yoshasudungan/qmk_firmware/keyboards/pheromone/keymaps/default/readme.md

# Default Keymap
---
The default keymap allows you contol 26 different sliders in lightroom.
## Base layer



## Function layer



## Lightroom layer
