yoshasudungan/qmk_firmware/mechanics/case/brand/brand.stl

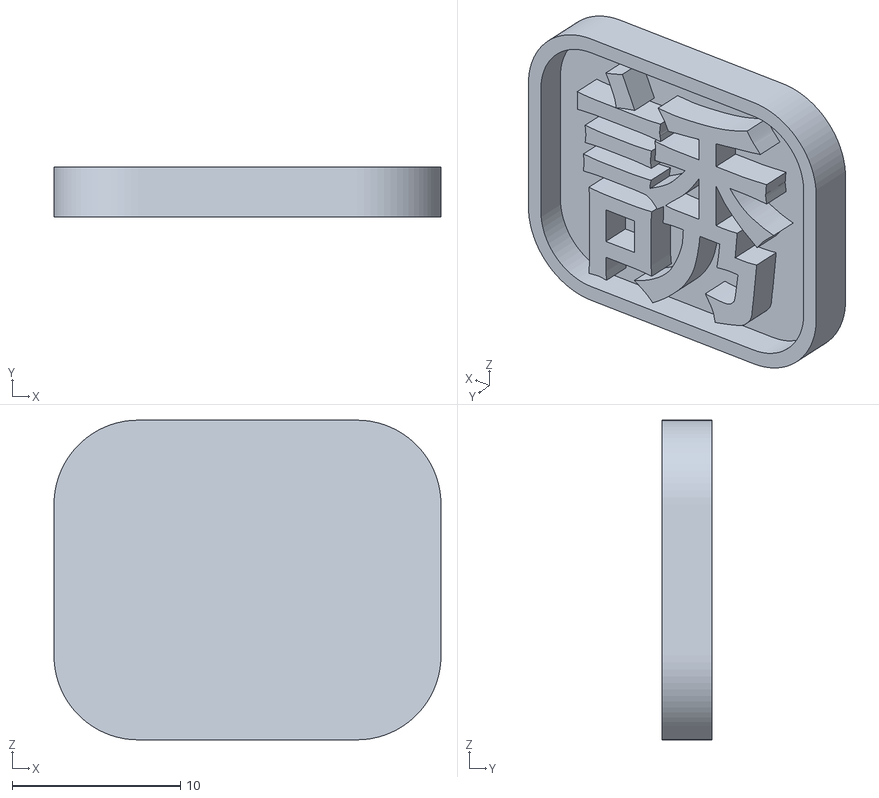
[picture p1: CAD file, 2020-08-31]
mechanics/case/brand/brand.stl
23.0 x 3.00 x 19.0
