yoshasudungan/qmk_firmware/mechanics/case/case.stl

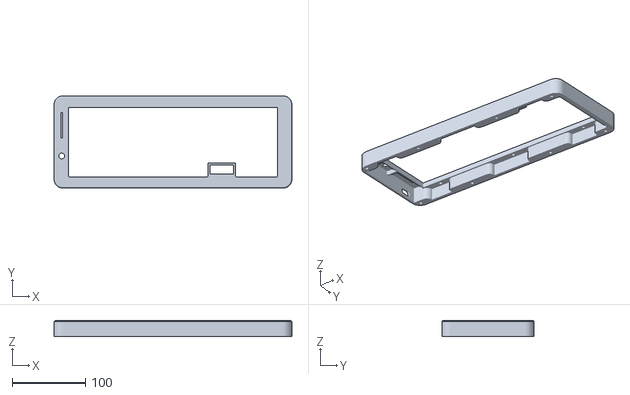
[picture p2: CAD file, 2020-08-31]
mechanics/case/case.stl
325.8 x 126.0 x 22.1
