yoshasudungan/qmk_firmware/mechanics/plate/Plate.step

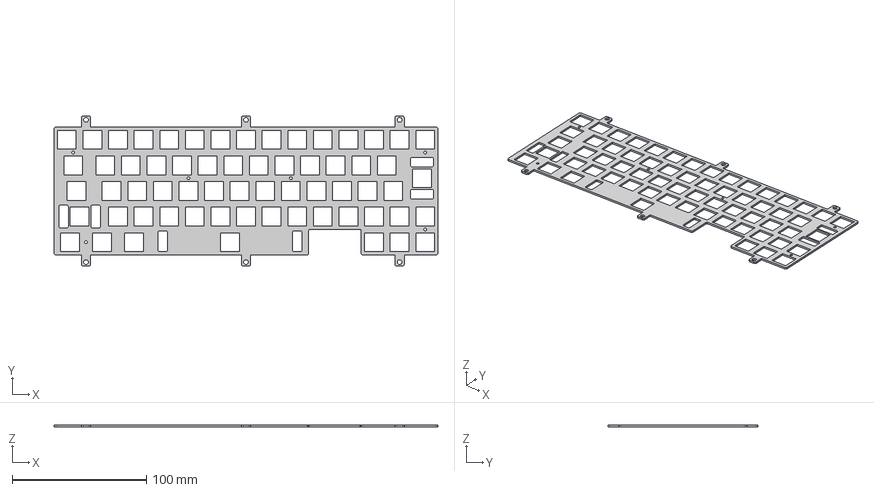
[picture p3: CAD file, 2020-08-31]
mechanics/plate/Plate.step
285.7 x 111.8 x 1.50 mm
