yoshasudungan/qmk_firmware/mechanics/slider cap/slide cap.stl

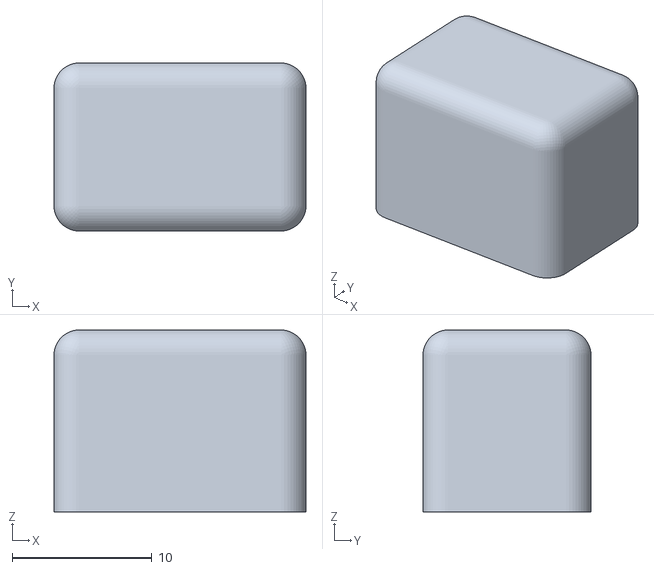
[picture p4: CAD file, 2020-08-31]
mechanics/slider cap/slide cap.stl
18.0 x 12.0 x 13.0
