yoshasudungan/qmk_firmware/mechanics/case/buttom_plate.dxf

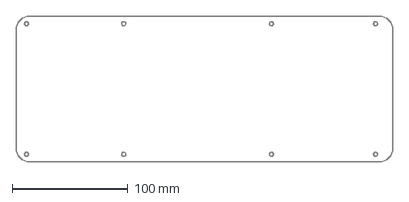
[picture p5: CAD file, 2020-08-31]
mechanics/case/buttom_plate.dxf
325.7 x 126.0 mm
