yoshasudungan/qmk_firmware/(list of files, cad)

Other CAD files:
mechanics/case/case_bigger_mounting_holes.stl
mechanics/case/case.f3z
mechanics/plate/plate.dxf
