yoshasudungan/qmk_firmware/pcb/pheromone.kicad_pcb

## KiCad design pcb/pheromone.kicad_pcb (2020-08-31)

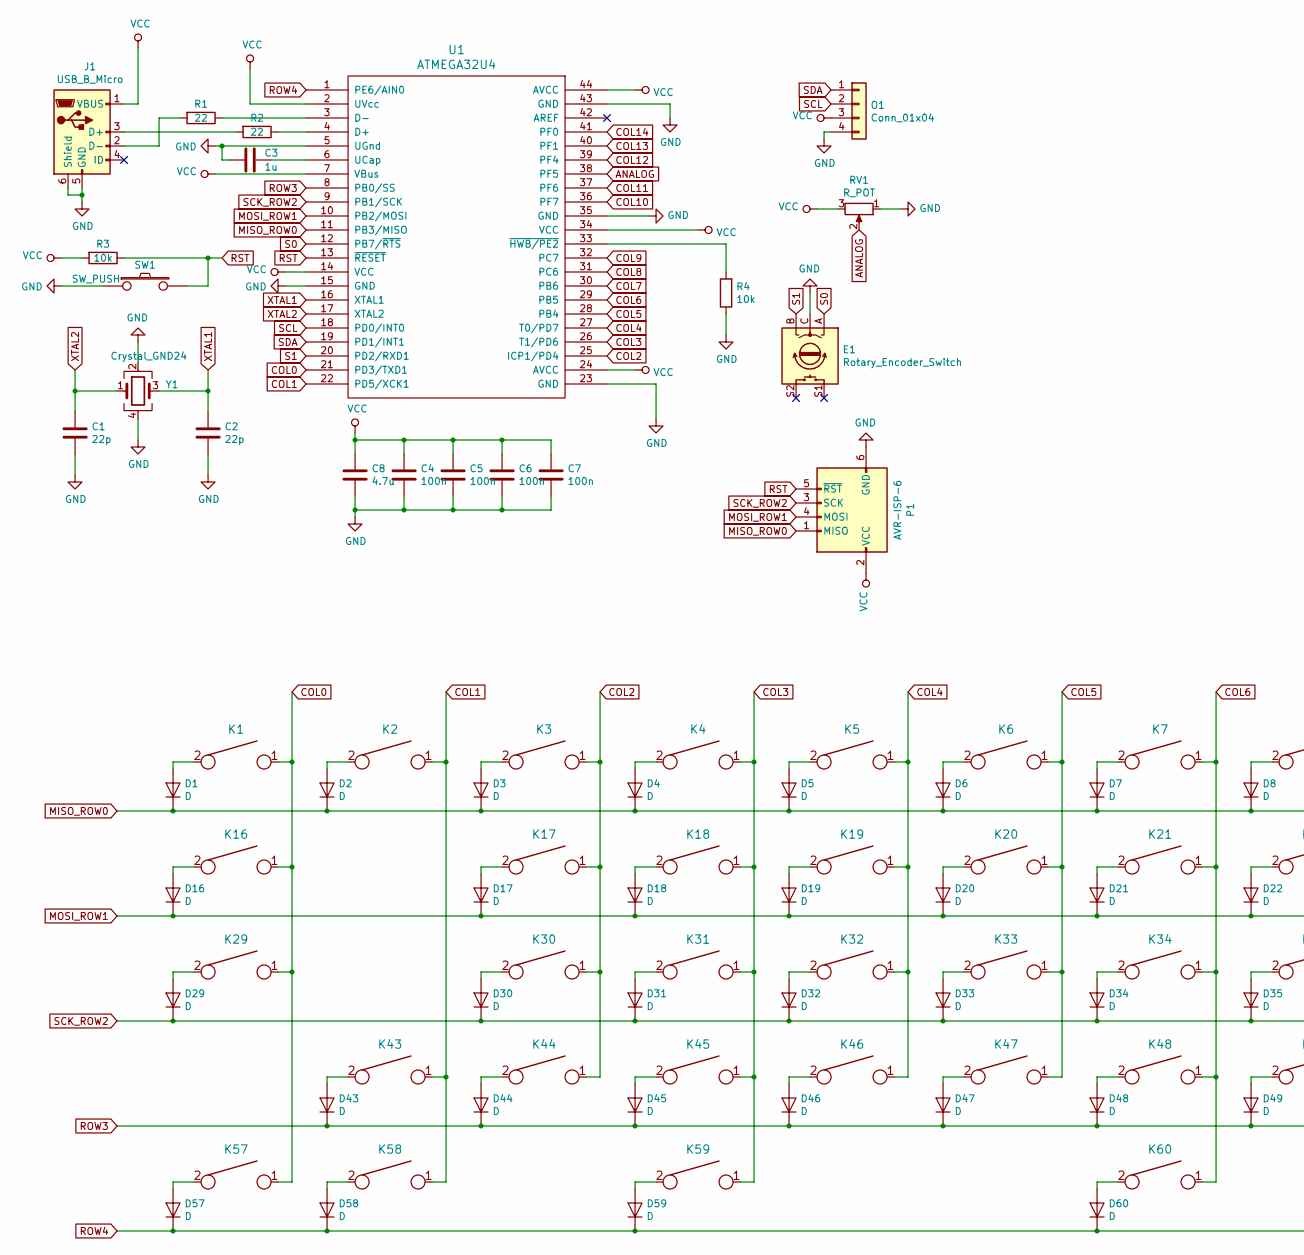
[picture p6: schematic pheromone.sch, Crusher keyboard, part in row 1, column 1]

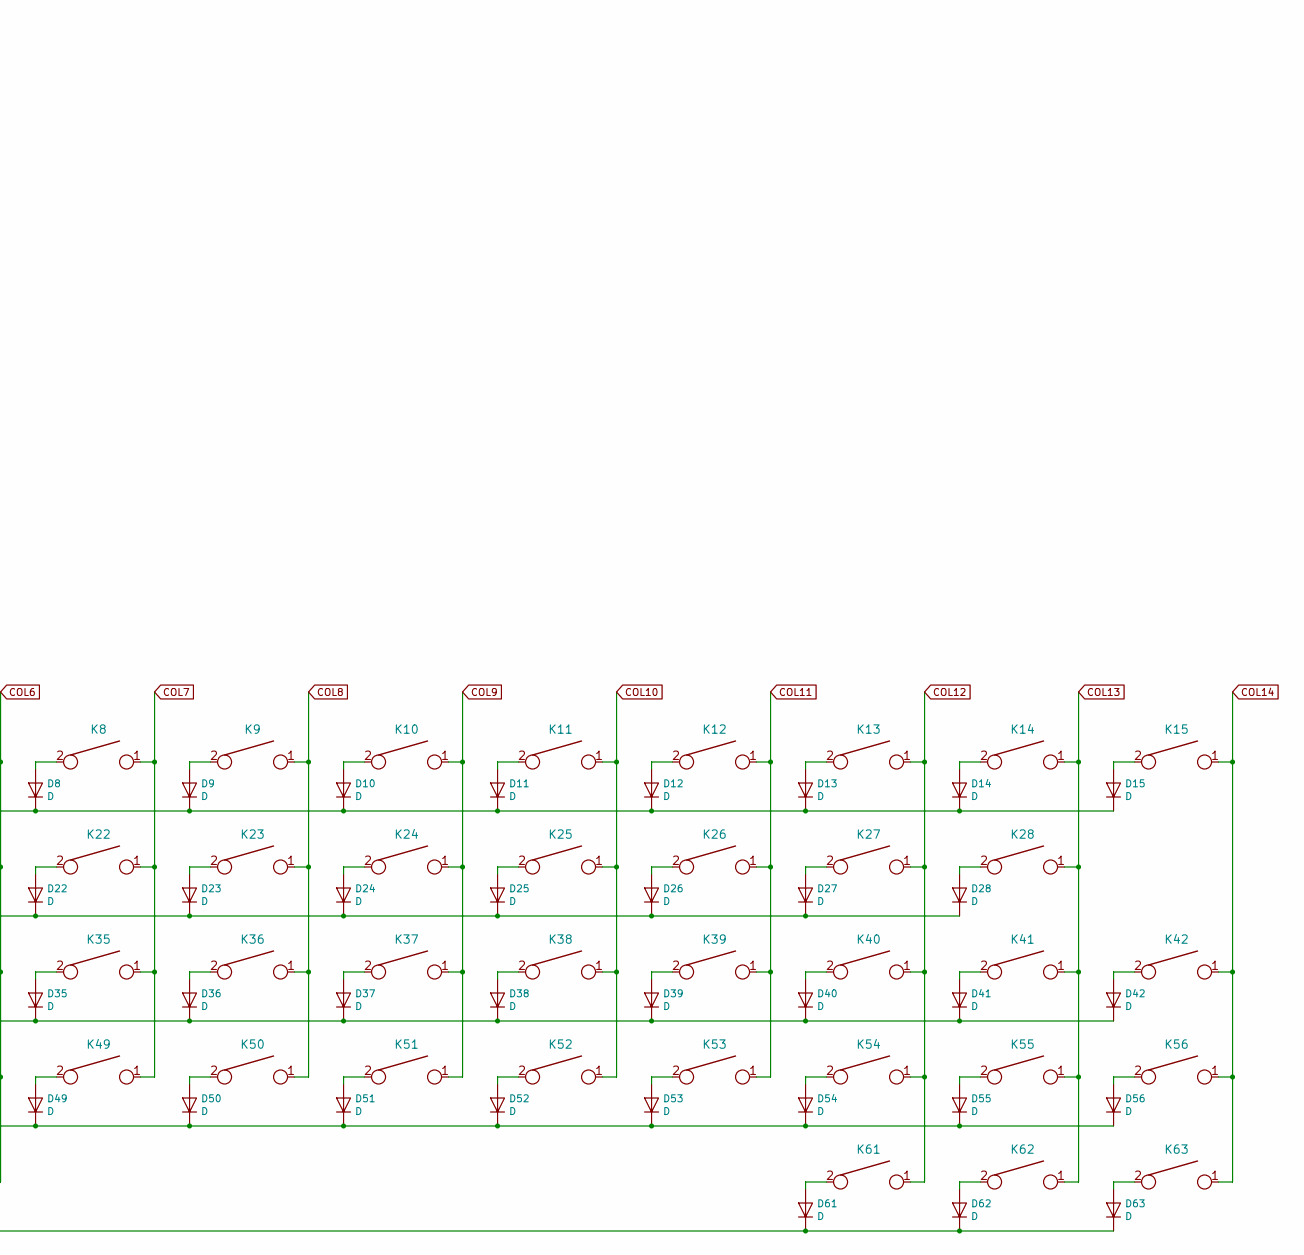
[picture p7: schematic pheromone.sch, Crusher keyboard, part in row 1, column 2]

Parts:
C1, C2: 22p; C_0805_2012Metric
C3: 1u; C_0805_2012Metric
C4, C5, C6, C7: 100n; C_0805_2012Metric
C8: 4.7u; C_0805_2012Metric
D1, D2, D3, D4, D5, D6, D7, D8, D9, D10, D11, D12, D13, D14, D15, D16, D17, D18, D19, D20, D21, D22, D23, D24, D25, D26, D27, D28, D29, D30, D31, D32, D33, D34, D35, D36, D37, D38, D39, D40, D41, D42, D43, D44, D45, D46, D47, D48, D49, D50, D51, D52, D53, D54, D55, D56, D57, D58, D59, D60, D61, D62, D63: D; D_SOD-123
E1: Rotary_Encoder_Switch; RotaryEncoder_Alps_EC11E-Switch_Vertical_H20mm
J1: USB_B_Micro; USB_Micro-B_Molex-105017-0001
K1, K2, K3, K4, K5, K6, K7, K8, K9, K10, K11, K12, K13, K14, K15, K17, K18, K19, K20, K21, K22, K23, K24, K25, K26, K27, K28, K30, K31, K32, K33, K34, K35, K36, K37, K38, K39, K40, K41, K44, K45, K46, K47, K48, K49, K50, K51, K52, K53, K54, K55, K56, K61, K62, K63: KEYSW; MXOnly-1U-Hotswap
K16: KEYSW; MXOnly-1.5U-Hotswap
K29: KEYSW; MXOnly-1.75U-Hotswap
K42: KEYSW; MXOnly-ISO-Hotswap
K43: KEYSW; MXOnly-2U-Hotswap-ReversedStabilizers
K57, K58, K59: KEYSW; MXOnly-1.25U-Hotswap
K60: KEYSW; MXOnly-6.25U-Hotswap-ReversedStabilizers
O1: Conn_01x04; 0.91_SSD1306_OLED
P1: AVR-ISP-6; PinHeader_2x03_P2.54mm_Vertical
R1, R2: 22; R_0805_2012Metric
R3, R4: 10k; R_0805_2012Metric
RV1: R_POT; potentiometer_slider_45mm
SW1: SW_PUSH; SW_DIP_SPSTx01_Slide_6.7x4.1mm_W6.73mm_P2.54mm_LowProfile_J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
U1: ATMEGA32U4; TQFP-44_10x10mm_Pitch0.8mm
Y1: Crystal_GND24; Crystal_SMD_3225-4Pin_3.2x2.5mm

Connections:
ANALOG: RV1.2, U1.38 (PF5)
COL0: K1.1, K16.1, K29.1, K57.1, U1.21 (PD3/TXD1)
COL1: K2.1, K43.1, K58.1, U1.22 (PD5/XCK1)
COL2: K3.1, K17.1, K30.1, K44.1, U1.25 (ICP1/PD4)
COL3: K4.1, K18.1, K31.1, K45.1, K59.1, U1.26 (T1/PD6)
COL4: K5.1, K19.1, K32.1, K46.1, U1.27 (T0/PD7)
COL5: K6.1, K20.1, K33.1, K47.1, U1.28 (PB4)
COL6: K7.1, K21.1, K34.1, K48.1, K60.1, U1.29 (PB5)
COL7: K8.1, K22.1, K35.1, K49.1, U1.30 (PB6)
COL8: K9.1, K23.1, K36.1, K50.1, U1.31 (PC6)
COL9: K10.1, K24.1, K37.1, K51.1, U1.32 (PC7)
COL10: K11.1, K25.1, K38.1, K52.1, U1.36 (PF7)
COL11: K12.1, K26.1, K39.1, K53.1, U1.37 (PF6)
COL12: K13.1, K27.1, K40.1, K54.1, K61.1, U1.39 (PF4)
COL13: K14.1, K28.1, K41.1, K55.1, K62.1, U1.40 (PF1)
COL14: K15.1, K42.1, K56.1, K63.1, U1.41 (PF0)
GND: C1.1, C2.1, C3.1, C4.1, C5.1, C6.1, C7.1, C8.1, E1.C, J1.5 (GND), J1.6 (Shield), O1.4, P1.6 (GND), R4.1, RV1.1, SW1.1, U1.5 (UGnd), U1.15 (GND), U1.23 (GND), U1.35 (GND), U1.43 (GND), Y1.2, Y1.4
MISO_ROW0: D1.1 (K), D2.1 (K), D3.1 (K), D4.1 (K), D5.1 (K), D6.1 (K), D7.1 (K), D8.1 (K), D9.1 (K), D10.1 (K), D11.1 (K), D12.1 (K), D13.1 (K), D14.1 (K), D15.1 (K), P1.1 (MISO), U1.11 (PB3/MISO)
MOSI_ROW1: D16.1 (K), D17.1 (K), D18.1 (K), D19.1 (K), D20.1 (K), D21.1 (K), D22.1 (K), D23.1 (K), D24.1 (K), D25.1 (K), D26.1 (K), D27.1 (K), D28.1 (K), P1.4 (MOSI), U1.10 (PB2/MOSI)
unnamed: C3.2, U1.6 (UCap)
unnamed: D1.2 (A), K1.2
unnamed: D2.2 (A), K2.2
unnamed: D3.2 (A), K3.2
unnamed: D4.2 (A), K4.2
unnamed: D5.2 (A), K5.2
unnamed: D6.2 (A), K6.2
unnamed: D7.2 (A), K7.2
unnamed: D8.2 (A), K8.2
unnamed: D9.2 (A), K9.2
unnamed: D10.2 (A), K10.2
unnamed: D11.2 (A), K11.2
unnamed: D12.2 (A), K12.2
unnamed: D13.2 (A), K13.2
unnamed: D14.2 (A), K14.2
unnamed: D15.2 (A), K15.2
unnamed: D16.2 (A), K16.2
unnamed: D17.2 (A), K17.2
unnamed: D18.2 (A), K18.2
unnamed: D19.2 (A), K19.2
unnamed: D20.2 (A), K20.2
unnamed: D21.2 (A), K21.2
unnamed: D22.2 (A), K22.2
unnamed: D23.2 (A), K23.2
unnamed: D24.2 (A), K24.2
unnamed: D25.2 (A), K25.2
unnamed: D26.2 (A), K26.2
unnamed: D27.2 (A), K27.2
unnamed: D28.2 (A), K28.2
unnamed: D29.2 (A), K29.2
unnamed: D30.2 (A), K30.2
unnamed: D31.2 (A), K31.2
unnamed: D32.2 (A), K32.2
unnamed: D33.2 (A), K33.2
unnamed: D34.2 (A), K34.2
unnamed: D35.2 (A), K35.2
unnamed: D36.2 (A), K36.2
unnamed: D37.2 (A), K37.2
unnamed: D38.2 (A), K38.2
unnamed: D39.2 (A), K39.2
unnamed: D40.2 (A), K40.2
unnamed: D41.2 (A), K41.2
unnamed: D42.2 (A), K42.2
unnamed: D43.2 (A), K43.2
unnamed: D44.2 (A), K44.2
unnamed: D45.2 (A), K45.2
unnamed: D46.2 (A), K46.2
unnamed: D47.2 (A), K47.2
unnamed: D48.2 (A), K48.2
unnamed: D49.2 (A), K49.2
unnamed: D50.2 (A), K50.2
unnamed: D51.2 (A), K51.2
unnamed: D52.2 (A), K52.2
unnamed: D53.2 (A), K53.2
unnamed: D54.2 (A), K54.2
unnamed: D55.2 (A), K55.2
unnamed: D56.2 (A), K56.2
unnamed: D57.2 (A), K57.2
unnamed: D58.2 (A), K58.2
unnamed: D59.2 (A), K59.2
unnamed: D60.2 (A), K60.2
unnamed: D61.2 (A), K61.2
unnamed: D62.2 (A), K62.2
unnamed: D63.2 (A), K63.2
unnamed: J1.2 (D-), R1.2
unnamed: J1.3 (D+), R2.2
unnamed: R1.1, U1.3 (D-)
unnamed: R2.1, U1.4 (D+)
unnamed: R4.2, U1.33 (~HWB/PE2)
ROW3: D43.1 (K), D44.1 (K), D45.1 (K), D46.1 (K), D47.1 (K), D48.1 (K), D49.1 (K), D50.1 (K), D51.1 (K), D52.1 (K), D53.1 (K), D54.1 (K), D55.1 (K), D56.1 (K), U1.8 (PB0/SS)
ROW4: D57.1 (K), D58.1 (K), D59.1 (K), D60.1 (K), D61.1 (K), D62.1 (K), D63.1 (K), U1.1 (PE6/AIN0)
RST: P1.5 (~RST), R3.1, SW1.2, U1.13 (~RESET)
S0: E1.A, U1.12 (PB7/~RTS)
S1: E1.B, U1.20 (PD2/RXD1)
SCK_ROW2: D29.1 (K), D30.1 (K), D31.1 (K), D32.1 (K), D33.1 (K), D34.1 (K), D35.1 (K), D36.1 (K), D37.1 (K), D38.1 (K), D39.1 (K), D40.1 (K), D41.1 (K), D42.1 (K), P1.3 (SCK), U1.9 (PB1/SCK)
SCL: O1.2, U1.18 (PD0/INT0)
SDA: O1.1, U1.19 (PD1/INT1)
VCC: C4.2, C5.2, C6.2, C7.2, C8.2, J1.1 (VBUS), O1.3, P1.2 (VCC), R3.2, RV1.3, U1.2 (UVcc), U1.7 (VBus), U1.14 (VCC), U1.24 (AVCC), U1.34 (VCC), U1.44 (AVCC)
XTAL1: C2.2, U1.16 (XTAL1), Y1.3
XTAL2: C1.2, U1.17 (XTAL2), Y1.1

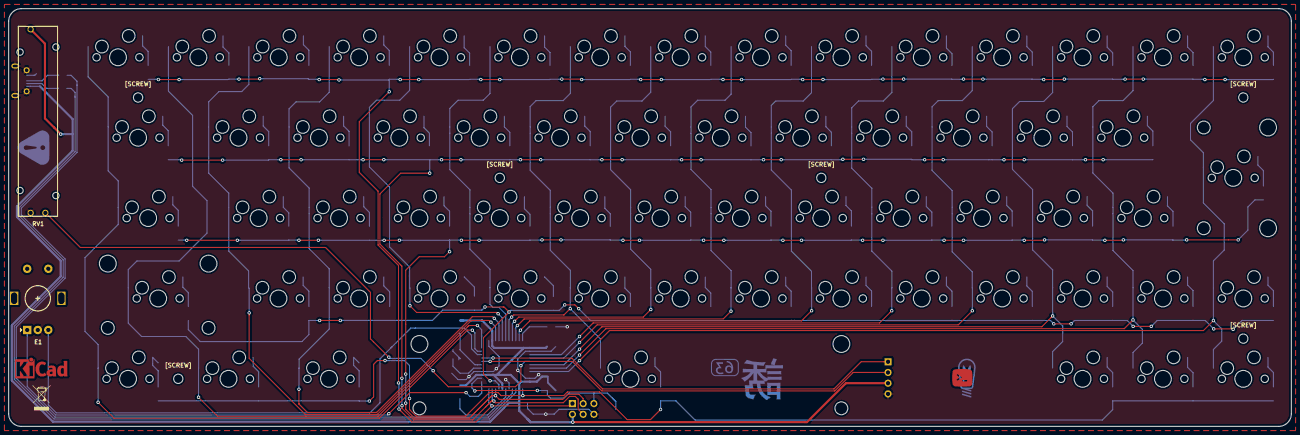
[picture p8: board pheromone.kicad_pcb from above]

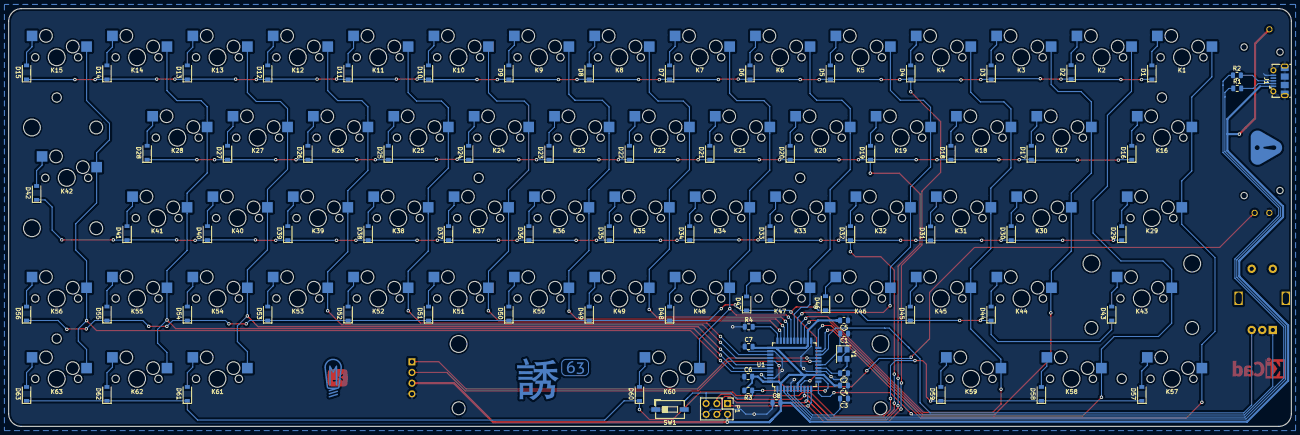
[picture p9: board pheromone.kicad_pcb from below]

Board: 2 copper layers, 304.0 x 99.0 mm, 152 parts (80 on the bottom side), 99 nets.

Other parts of the board:
[SCREW]: MountingHole_2.2mm_M2
[SCREW]#2, [SCREW]#3, [SCREW]#4, [SCREW]#5, [SCREW]#6: MountingHole_2.2mm_M2
